BBBSnowball/glasgow/hardware/boards/glasgow-light/glasgow.kicad_pcb

## KiCad design hardware/boards/glasgow-light/glasgow.kicad_pcb (2021-03-02)

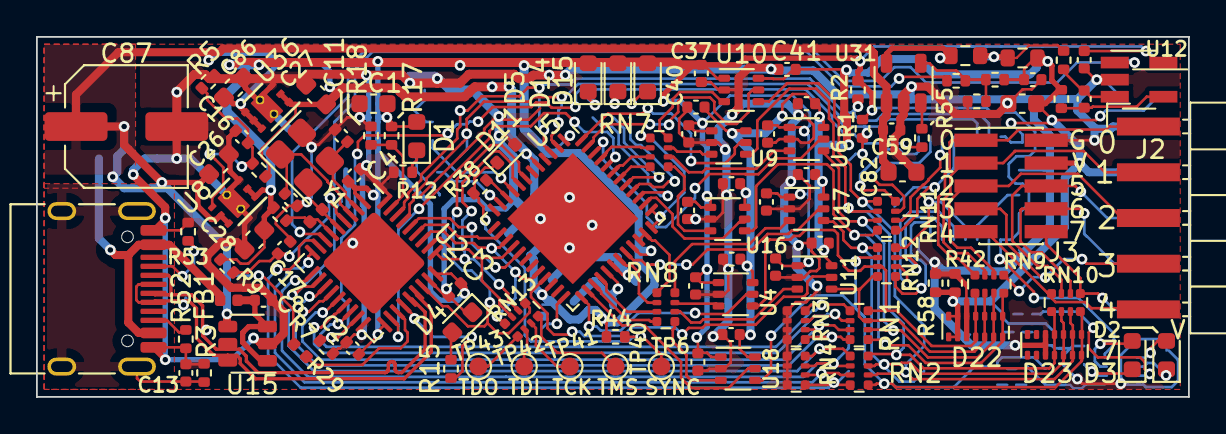
[picture p1: board glasgow.kicad_pcb from above]

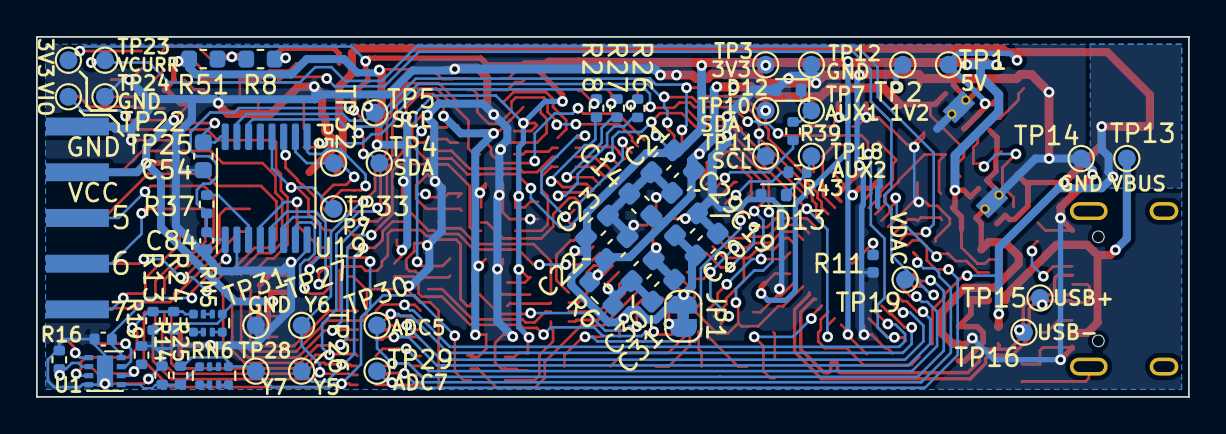
[picture p2: board glasgow.kicad_pcb from below]

Board: 2 copper layers, 64.0 x 20.0 mm, 173 parts (62 on the bottom side), 128 nets.

Parts:
C1, C26, C27, C28, C82, C83, C86: 4u7; C_0603_1608Metric
C2, C3, C4, C8, C13, C15, C16, C17, C32, C34, C35, C36, C37, C38, C39, C40, C41, C42, C43, C47, C48, C49, C50, C51, C52, C55, C57, C58, C59, C84: u1; C_0402_1005Metric
C11, C12: 9p; C_0402_1005Metric
C14, C19, C30: 4u7; C_0603_1608Metric_Pad1.08x0.95mm_HandSolder
C20, C21, C22, C23, C29, C31: u1; C_0603_1608Metric_Pad1.08x0.95mm_HandSolder
C54: u1; C_0603_1608Metric
C87: 150u; CP_Elec_6.3x5.9
D1: GRN; LED_0603_1608Metric
D2: GREEN; LED_0603_1608Metric
D3: YELLOW; LED_0603_1608Metric
D4, D5, D14, D15: YEL; LED_0603_1608Metric
D11, D12, D13: ESD5Z5.0T1G; D_SOD-523
D22, D23: SP3012-06UTG; UDFN-14_3.5x1.35mm_P0.5mm
FB1: 600R, 0.5A; L_0402_1005Metric
J1: USB_C_USB2.0; USB_C_Receptacle_HRO_TYPE-C-31-M-12
J2: IDC-Header_2x5_P2.54mm; PinHeader_2x05_P2.54mm_BoardEdge
J3: IDC-Header_2x5_P2.54mm; PinHeader_2x05_P1.27mm_Vertical_SMD
JP1: SolderJumper_2_Bridged; SolderJumper-2_P1.3mm_Bridged_RoundedPad1.0x1.5mm
R1, R2, R15, R42, R58: 2k2; R_0402_1005Metric
R3, R5, R18: 100k; R_0402_1005Metric
R4: 1k; R_0402_1005Metric
R6: 100; R_0603_1608Metric_Pad0.98x0.95mm_HandSolder
R7, R9, R37, R44, R55: 10k; R_0402_1005Metric
R8, R51: DNP; R_0603_1608Metric_DNP
R10, R11, R26, R27, R28, R29: 0; R_0402_1005Metric
R12: 20k; R_0402_1005Metric
R13, R14: 50k; R_0402_1005Metric
R16, R19: 270; R_0402_1005Metric
R17: DNP; R_0402_1005Metric
R24, R25: DNP/400k; R_0402_1005Metric
R30, R54: 4R7; R_0402_1005Metric
R33: 49k9; R_0402_1005Metric
R34: 59k; R_0402_1005Metric
R35: 24k3; R_0402_1005Metric
R38, R39, R43: 47R; R_0402_1005Metric
R49: 0R10; R_0603_1608Metric
R52, R53: 5k1; R_0402_1005Metric
R56: 0R68; R_0603_1608Metric
RN1, RN2, RN3, RN4, RN5, RN6: 100k; R_Array_Convex_4x0402
RN7, RN8, RN9, RN10, RN13: 33R; R_Array_Convex_4x0402
RN11, RN12: 10k; R_Array_Convex_4x0402
TP1: 5V; TestPoint_Pad_D1.0mm
TP2: 1V2; TestPoint_Pad_D1.0mm
TP3, TP22: 3V3; TestPoint_Pad_D1.0mm
TP4, TP10: SDA; TestPoint_Pad_D1.0mm
TP5, TP11: SCL; TestPoint_Pad_D1.0mm
TP6: SYNC; TestPoint_Pad_D1.0mm
TP7: AUX1; TestPoint_Pad_D1.0mm
TP12, TP24, TP31: GND; TestPoint_Pad_D1.0mm
TP13: VBUS; TestPoint_Pad_D1.0mm
TP14: USBGND; TestPoint_Pad_D1.0mm
TP15: USBDP; TestPoint_Pad_D1.0mm
TP16: USBDM; TestPoint_Pad_D1.0mm
TP18: AUX2; TestPoint_Pad_D1.0mm
TP19: VDAC; TestPoint_Pad_D1.0mm
TP23: VCURR; TestPoint_Pad_D1.0mm
TP25: VIO; TestPoint_Pad_D1.0mm
TP26: Y5; TestPoint_Pad_D1.0mm
TP27: Y6; TestPoint_Pad_D1.0mm
TP28: Y7; TestPoint_Pad_D1.0mm
TP29: ADC7; TestPoint_Pad_D1.0mm
TP30: ADC5; TestPoint_Pad_D1.0mm
TP32: P5; TestPoint_Pad_D1.0mm
TP33: P7; TestPoint_Pad_D1.0mm
TP40: TMS; TestPoint_Pad_D1.0mm
TP41: TCK; TestPoint_Pad_D1.0mm
TP42: TDI; TestPoint_Pad_D1.0mm
TP43: TDO; TestPoint_Pad_D1.0mm
U1: LM358_DFN; DFN-8-1EP_2x2mm_P0.5mm_EP1.05x1.75mm
U2: GD32VF103T; QFN-36-1EP_6x6mm_P0.5mm_EP4.1x4.1mm
U4, U6, U9, U10, U11, U16, U17, U18: SN74LVC1T45DCKR; SOT-363_SC-70-6
U5: ICE40UP5K-SG48ITR; QFN-48-1EP_7x7mm_P0.5mm_EP5.15x5.15mm
U8: TLV75533PDRVR; DFN-6-1EP_2x2mm_P0.65mm_EP1x1.6mm_ThermalVias
U12: INA180A2; SOT-23-5_HandSoldering
U15: TPD3S014; SOT-23-6
U19: PCA6408APW; TSSOP-16_4.4x5mm_P0.65mm
U31: TPS73101DBV; SOT-23-5
U36: TLV73312PQDRVR; DFN-6-1EP_2x2mm_P0.65mm_EP1x1.6mm_ThermalVias
Y1: 8M; Crystal_SMD_3225-4Pin_3.2x2.5mm

Connections:
+1V2: C14.1, C22.1, C27.1, C29.1, R4.1, R6.2, TP2.1, U5.5, U5.30, U36.1, U36.2
+3V3: C1.1, C2.1, C3.1, C4.1, C19.1, C20.1, C21.1, C23.1, C28.1, C32.1, C34.1, C35.1, C36.1, C37.1, C42.1, C43.1, C47.1, C48.1, C55.1, C84.1, D1.2, D5.2, D14.2, D15.2, JP1.1, R1.2, R2.2, R9.1, R10.2, R17.1, R37.2, R44.2, TP3.1, TP22.1, U1.8, U2.1, U2.19, U2.27, U4.1, U5.1, U5.22, U5.33, U6.1, U8.1, U8.2, U9.1, U10.1, U11.1, U12.5, U16.1, U17.1, U18.1, U19.1
+5V: C26.2, C59.1, C82.1, C86.2, C87.1, R29.1, TP1.1, U8.5, U8.6, U15.4, U31.1, U36.4, U36.5, U36.6
/AUX1: R39.2, U5.9
/AUX2: R43.2, U5.11
/BOOT0: R17.2, R18.1, U2.35
/CC1: J1.A5, R53.2
/CC2: J1.B5, R52.2
/CLKREF: U2.20, U5.44
/DA0: U4.5, U5.25
/DA1: U5.21, U11.5
/DA2: U5.46, U6.5
/DA3: U5.38, U16.5
/DA4: U5.48, U9.5
/DA5: U5.32, U17.5
/DA6: U5.47, U10.5
/DA7: U5.26, U18.5
/FPGA_DONE: RN13.1, U2.25, U5.7
/IO_Banks/AUX1~: D12.1, R39.1, TP7.1
/IO_Banks/AUX2~: D13.1, R43.1, TP18.1
/IO_Banks/IO_Buffer_A/P0: RN12.8, U19.4
/IO_Banks/IO_Buffer_A/P1: RN12.6, U19.5
/IO_Banks/IO_Buffer_A/P2: RN12.7, U19.6
/IO_Banks/IO_Buffer_A/P3: RN12.5, U19.7
/IO_Banks/IO_Buffer_A/P4: RN11.8, U19.9
/IO_Banks/IO_Buffer_A/P5: RN11.7, TP32.1, U19.10
/IO_Banks/IO_Buffer_A/P6: RN11.6, U19.11
/IO_Banks/IO_Buffer_A/P7: RN11.5, TP33.1, U19.12
/IO_Banks/IO_Buffer_A/VFB: R33.2, R34.1, R35.2, U31.4
/IO_Banks/IO_Buffer_A/VIO_EN: R55.1, U31.3
/IO_Banks/IO_Buffer_A/X0: RN7.8, U10.3
/IO_Banks/IO_Buffer_A/Y0: D22.4, D22.11, RN1.4, RN9.1, RN12.3, U4.4
/IO_Banks/IO_Buffer_A/Y1: D22.3, D22.12, RN1.3, RN9.2, RN12.4, U11.4
/IO_Banks/IO_Buffer_A/Y2: D22.2, D22.13, RN1.2, RN9.3, RN11.3, U6.4
/IO_Banks/IO_Buffer_A/Y3: D22.1, D22.14, RN1.1, RN9.4, RN11.4, U16.4
/IO_Banks/IO_Buffer_A/Y4: D23.4, D23.11, RN2.4, RN10.1, RN11.2, U9.4
/IO_Banks/IO_Buffer_A/Y5: D23.3, D23.12, RN2.3, RN10.2, RN12.1, TP26.1, U17.4
/IO_Banks/IO_Buffer_A/Y6: D23.2, D23.13, RN2.2, RN10.3, RN11.1, TP27.1, U10.4
/IO_Banks/IO_Buffer_A/Y7: D23.1, D23.14, R25.2, RN2.1, RN6.5, RN10.4, RN12.2, TP28.1, U18.4
/IO_Banks/IO_Buffer_A/Z0: J2.1, J3.1, RN9.8
/IO_Banks/IO_Buffer_A/Z1: J2.3, J3.3, RN9.7
/IO_Banks/IO_Buffer_A/Z2: J2.5, J3.5, RN9.6
/IO_Banks/IO_Buffer_A/Z3: J2.7, J3.7, RN9.5
/IO_Banks/IO_Buffer_A/Z4: J2.9, J3.9, RN10.8
/IO_Banks/IO_Buffer_A/Z5: J2.6, J3.6, RN10.7
/IO_Banks/IO_Buffer_A/Z6: J2.8, J3.8, RN10.6
/IO_Banks/IO_Buffer_A/Z7: J2.10, J3.10, RN10.5
/IO_Banks/VIOA: C38.1, C39.1, C40.1, C41.1, C49.1, C50.1, C51.1, C52.1, C54.1, C57.1, C83.1, D22.6, D22.7, D22.8, D22.9, J2.4, J3.4, R24.2, R34.2, R42.2, R49.2, R51.2, R54.1, R58.2, RN5.5, TP25.1, U4.6, U6.6, U9.6, U10.6, U11.6, U16.6, U17.6, U18.6, U19.16
/IO_Banks/~SYNC: D11.1, R38.1, R44.1, TP6.1
/LED0: R26.2, U5.39
/LED1: R27.2, U5.41
/LED2: R28.2, U5.40
/LED_ACT: R15.1, U2.22
/NRST: C17.1, R9.2, U2.4
/QA0: RN8.2, U5.31
/QA1: RN8.3, U5.28
/QA2: RN7.3, U5.43
/QA3: RN7.4, U5.42
/QA4: RN7.2, U5.45
/QA5: RN8.1, U5.34, U5.35
/QA6: RN7.1, U5.36, U5.37
/QA7: RN8.4, U5.27
/SCL: R1.1, TP4.1, TP11.1, U2.33, U5.2, U19.14
/SDA: R2.1, TP5.1, TP10.1, U2.34, U5.3, U19.15
/SHLD: C13.1, J1.S1, R3.1
/TCK: RN13.7, TP41.1
/TDI: RN13.6, TP42.1
/TDO: RN13.5, TP43.1
/TMS: RN13.8, TP40.1
/USB_N: J1.A7, J1.B7, TP16.1, U2.23, U15.5
/USB_P: J1.A6, J1.B6, TP15.1, U2.24, U15.6
/VCCPLL: C30.1, C31.1, R6.1, U5.29
/VDDA: C15.1, R10.1, U2.6
/VUSB: C8.1, FB1.2, U15.1, U15.3
/XTALIN: C12.1, U2.3, Y1.1
/XTALOUT: C11.1, U2.2, Y1.3
/xVBUS: FB1.1, J1.A4, J1.A9, J1.B4, J1.B9, TP13.1
/~FPGA_RESET: RN13.2, U2.28, U5.8
/~SYNC_INT: R38.2, U5.10
ADC0: RN1.5, RN3.4, U2.16
ADC1: RN1.6, RN3.3, U2.15
ADC2: RN1.7, RN3.2, U2.14
ADC3: RN1.8, RN3.1, U2.13
ADC4: RN2.5, RN4.4, U2.12
ADC5: RN2.6, RN4.3, TP30.1, U2.10
ADC6: RN2.7, RN4.2, U2.9
ADC7: RN2.8, RN4.1, TP29.1, U2.8
FPGA_CS: RN13.3, U2.29, U5.16
FPGA_MISO: U2.31, U5.14
FPGA_MOSI: U2.32, U5.17
FPGA_SCK: RN13.4, U2.30, U5.15, U5.20
GND: C1.2, C2.2, C3.2, C4.2, C8.2, C11.2, C12.2, C13.2, C14.2, C15.2, C16.2, C17.2, C19.2, C20.2, C21.2, C22.2, C23.2, C26.1, C27.2, C28.2, C29.2, C30.2, C31.2, C32.2, C34.2, C35.2, C36.2, C37.2, C38.2, C39.2, C40.2, C41.2, C42.2, C43.2, C47.2, C48.2, C49.2, C50.2, C51.2, C52.2, C54.2, C55.2, C57.2, C59.2, C82.2, C83.2, C84.2, C86.1, C87.2, D4.1, D11.2, D12.2, D13.2, D22.5, D22.10, D23.5, D23.10, J1.A1, J1.A12, J1.B1, J1.B12, J2.2, J3.2, R3.2, R5.2, R7.1, R11.2, R12.2, R13.2, R14.2, R16.2, R18.2, R19.2, R35.1, R42.1, R52.1, R53.1, R58.1, RN3.5, RN3.6, RN3.7, RN3.8, RN4.5, RN4.6, RN4.7, RN4.8, TP12.1, TP14.1, TP24.1, TP31.1, U1.4, U1.9, U2.5, U2.18, U2.26, U2.36, U4.2, U5.49, U6.2, U8.3, U8.7, U9.2, U10.2, U11.2, U12.2, U15.2, U16.2, U17.2, U18.2, U19.2, U19.8, U31.2, U36.3, U36.7, Y1.2, Y1.4
unnamed: C16.1, R4.2, R5.1, U8.4
unnamed: C58.1, R54.2, U12.4
unnamed: C58.2, R30.2, U12.3
unnamed: D1.1, R12.1
unnamed: D2.1, R16.1, U1.2
unnamed: D2.2, U1.1
unnamed: D3.1, R19.1, U1.6
unnamed: D3.2, U1.7
unnamed: D4.2, R15.2
unnamed: D5.1, R26.1
unnamed: D14.1, R27.1
unnamed: D15.1, R28.1
unnamed: JP1.2, U5.24
unnamed: R11.1, U2.37
unnamed: R13.1, R24.1, RN5.8, U1.3
unnamed: R14.1, R25.1, RN6.8, U1.5
unnamed: R29.2, U2.21
unnamed: R8.2, R30.1, R49.1, R51.1, R56.2
unnamed: R37.1, U19.3
unnamed: R8.1, R56.1, U31.5
unnamed: RN5.1, RN5.2
unnamed: RN5.3, RN5.4
unnamed: RN5.6, RN5.7
unnamed: RN6.1, RN6.2
unnamed: RN6.3, RN6.4
unnamed: RN6.6, RN6.7
unnamed: RN7.5, U16.3
unnamed: RN7.6, U6.3
unnamed: RN7.7, U9.3
unnamed: RN8.5, U18.3
unnamed: RN8.6, U11.3
unnamed: RN8.7, U4.3
unnamed: RN8.8, U17.3
VIO_CURRENT: TP23.1, U2.7, U12.1
VIO_DAC: R33.1, TP19.1, U2.11
VIO_ENA: R7.2, R55.2, U2.17
