BBBSnowball/glasgow/(commit log)

2021-01-04 start with glasgow-light
    [glasgow.kicad_pcb, glasgow.sch, io_banks.sch, io_buffer.sch, revb.sch]
2021-01-04 swap some pins
    [glasgow.kicad_pcb, io_buffer.sch]
2021-01-06 place&route the buffers
    [glasgow.kicad_pcb]
2021-01-06 fix routing problems near the buffers
    [glasgow.kicad_pcb]
2021-01-06 route resistor arrays between FPGA and buffers
    [glasgow.kicad_pcb, glasgow.sch, io_buffer.sch]
2021-01-06 increase width of supply lines
    [glasgow.kicad_pcb]
2021-01-06 add some test points
    [glasgow.kicad_pcb, glasgow.sch, io_buffer.sch]
2021-01-06 add LEDs for VIO and Y7
    [glasgow.kicad_pcb, glasgow.sch, io_banks.sch, io_buffer.sch, led_analog.sch]
2021-01-06 add alternative resistors
    We might not want to place any resistor arrays on the bottom side
    because we will most likely hand-solder it.
    [glasgow.kicad_pcb, led_analog.sch]
2021-01-08 start routing FPGA
    [glasgow.kicad_pcb, glasgow.sch, io_banks.sch, io_buffer.sch]
2021-01-08 right side of FPGA routed
    [glasgow.kicad_pcb, glasgow.sch]
2021-01-09 continue routing around FPGA
    [glasgow.kicad_pcb, glasgow.sch]
2021-01-09 swap some of the DAx pins, again
    [glasgow.kicad_pcb, glasgow.sch]
2021-02-25 open project on another host
    [glasgow.sch, io_banks.sch, io_buffer.sch, led_analog.sch]
2021-02-25 add GD32VF103T in QFN36 package
    [glasgow.kicad_pcb, glasgow.sch]
2021-02-27 rotate GD32 -> routing is *much* easier
    [glasgow.kicad_pcb, glasgow.sch]
2021-02-27 replace SYNC and AUX connectors by test points
    [glasgow.kicad_pcb, glasgow.sch, io_banks.sch]
2021-02-27 most components are placed
    [glasgow.kicad_pcb, glasgow.sch, io_banks.sch]
2021-02-28 make the board a bit smaller
    [glasgow.kicad_pcb]
2021-02-28 make board another bit smaller -> outer size is metric
    [glasgow.kicad_pcb]
2021-02-28 add optional connection for exposed pad of GD32VF
    The datasheet doesn't say whether we should connect it to GND.
    [glasgow.kicad_pcb]
2021-02-28 optimize location of test points
    [glasgow.kicad_pcb]
2021-02-28 start optimizing silk
    [glasgow.kicad_pcb, io_banks.sch]
2021-02-28 add silk for connectors
    [glasgow.kicad_pcb]
2021-03-02 add solder jumper for VPP_2V5
    [glasgow.kicad_pcb, glasgow.sch]
2021-03-02 optimize a few wires
    [glasgow.kicad_pcb]
